GauthierBct/canne_avertisseuse/(commit log)

2020-06-29 supprimé la fonction "réception", mise a jour du délestage batterie et des LEDs msg et fusion avec la version sans sommeil
2020-06-29 fusion avec la version sans sommeil
2020-07-02 nouvelle version du circuit
2020-07-03 mise a jour de la foncgtion lecture gps
2020-07-03 toute les communications inutiles mise en commentaires
2020-07-10 mise a jour de la led lora et des coordonées gps
